T-labDevelopment/Voice_Memory/development/v2/README.md

# VoiceMemory v2 — 現行の製造承認版

**管理上の状態：製造承認済み（2026-11-11、ユーザー明示承認）**  
**製造基準：** `voicememory-2026-11-11_164201.zip`（2026-11-11 16:44 JST受領）

| 項目 | 内容 |
|---|---|
| 現行版 | **VoiceMemory v2** |
| 承認状態 | **製造承認済み（プロジェクト責任者による承認）** |
| 承認日 | 2026-11-11 |
| 承認対象 | [原本ZIP](../../hardware/source-archives/v2-baseline/voicememory-2026-11-11_164201.zip) |
| 原本SHA-256 | `a64d1d4d439a141a7048c7fe233227507cebeaa69209cd91ddddc90118438c7a` |
| 原本KiCad反映コミット | `e46e8d026885804b8783181245f9a54b088f07ca` |
| 承認記録 | [製造承認台帳](../../releases/v2-manufacturing-approved-2026-11-11/README.md) |
| 最新KiCad | [`hardware/kicad/voicememory/`](../../hardware/kicad/voicememory/) |
| 管理ブランチ | `develop/v2` |
| 旧v1 | [旧試作・製造検証資料](../../releases/v1-prototype/README.md)、費用計算不要 |

## 承認に関する証拠の区別

- **製造承認：あり。** プロジェクト責任者（ユーザー）が2026-11-11に上記v2 ZIPの製造承認を明示した。
- **ERC：実施済み（ユーザー申告）。DRC：実施済み（ユーザー申告）。**
- **KiCad CLIの独立再実行：なし。** ERC／DRCの正式レポートは原本ZIPに未収録。エラー／警告の個別件数は確認できておらず、**「ERC/DRCエラー0件・警告0件を検証済み」とは記さない**。
- 承認対象は上記固定ZIPと、その内容をGitHubに取り込んだKiCad一式。将来の変更、別ロットへの設計変更を包括承認するものではない。
- ファームウェアの完成・無線機との実機検証・量産品質保証の完了を意味しない。

## v2設計仕様（今回の製造基準）

- CH32V003F4P6、32Mbit SPI Flash（W25Q32RVCSJM）、NJM2732D、TLP592A(F)、AZ8462-3。
- 単3乾電池×3本、3.3V LDO。マイクと無線機の各RJ45 8P8C。
- M1～M4の4チャンネル録音・再生、ループ再生、マイクPTT優先と録音中の誤送信防止を目標仕様とする。ファームウェアの動作合格は別途管理。
- 最新の回路図・PCB・フットプリントは**11月11日ZIPの内容を優先**。
- 2026-11-10のコンデンサ干渉報告（C7/C10/C16/C19等）は、**旧PCBに対する履歴記録**。11月11日製造承認版の現存不良とはみなさない。

## 開発と調達

- [v2費用と必要仕様](DEVELOPMENT_AND_COST_SCOPE_JA.md)：費用はv2側で管理。調達額・組立費・開発工数は必要時に見積。
- [最新の受領・差分記録](../../hardware/reports/V2_BASELINE_RECEIPT_2026-11-11_JA.md)。
- 新しい修正を加える際には、この承認版を保持し、別コミット／ブランチで変更履歴と検証証拠を管理する。

**旧v1は独立した試作・製造検証用参照資料として保持し、v1の費用計算は行わない。**
