T-labDevelopment/Voice_Memory/releases/v1-prototype/README.md

# VoiceMemory v1 — 試作／製造検証用の基準資料

**位置付け：旧v1試作版（2026-10-30）。製造検証の比較・入力基準として保管し、現在の開発対象にはしない。費用計算は行わない。**

> **重要:** v1は製造検証のための参照元であり、「製造承認済み」「ERC/DRC済み」「動作保証済み」を意味しない。現在の設計を扱う場合は [v2開発版](../../development/v2/README.md) を参照する。

## 参照優先順位

1. **旧v1リリースZIP原本** `VoiceMemory_v1_ECO_2026-10-30_KiCad10(1).zip`（ユーザーが2026-11-11に提示）。
2. [同ZIPのファイル単位照合・SHA記録](../../hardware/reports/ECO_ZIP_RECEIPT_COMPARE_2026-11-11_JA.md)。
3. [2026-10-30 ECO変更記録](../../hardware/reports/ECO_2026-10-30_JA.md)。
4. [旧v1製造検証用チェックリスト](../../hardware/reports/ECO_RELEASE_CHECKLIST_2026-10-30_JA.md)。
5. [旧版ファームウェア仕様資料](../../docs/firmware-hardware/v1/README.md)（10月29日等の旧資料を含み、回路一致を要再照合）。

**原本ZIPは現在GitHubにバイナリとして登録できていない。** このフォルダは索引と同定情報を保存するもので、原本の完全な代替ではない。GitHubの `hardware/kicad/voicememory/` にあるSCH/PCBは**後続v2版**であり、旧v1原本と取り違えないこと。

## 原本識別情報

| 項目 | 内容 |
|---|---|
| 呼称 | VoiceMemory v1 試作／製造検証版 |
| 原本ファイル | `VoiceMemory_v1_ECO_2026-10-30_KiCad10(1).zip` |
| 作成基準日 | 2026-10-30 |
| 原本SHA-256 | `4701e9fb30755c0f9fe3589d3cfbdebf8b4f2a751e774f449c357264064692ce` |
| ZIP容量 | 134,456 byte |
| 収録 | 15ファイル（KiCad 10回路図・PCB・ライブラリ、ECO変更記録・監査資料） |
| 同一性確認 | 現行GitHubの15対応ファイル中13件は同一Git Blob SHA。差分2件は回路図とPCB |
| GitHubへ元ZIP格納 | **未完了** |
| v1の費用計算 | **不要／実施しない** |
| KiCad ERC / DRC | 未実施、エラー0件の検証は未達 |
| 製造承認 | **未承認** |

## v1試作の主要仕様

| 分野 | v1試作構成 |
|---|---|
| MCU | CH32V003F4P6 / 3.3V |
| SPI Flash | W25Q32RVCSJM / 32Mbit (4MiB)、208mil SOP-8 |
| 音声回路 | NJM2732Dデュアルアンプ、ADC録音／PWM再生 |
| 自動PTT | TLP592A(F) PhotoMOS |
| マイク音声・PTT切替 | AZ8462-3、3V DPDTリレー |
| 音声メモリ | M1～M4、4チャンネル |
| 想定PCM | 8kHz / 8bit / モノラル（FWで確定・検証が必要） |
| 録音上限 | 連続120秒で安全停止。120秒の保証ではない |
| 電源 | 単3×3本、3.3V LDO |
| 外部接続 | マイク側・無線機側RJ45 8P8C、WCH-Link |
| 操作 | REC＋M1～M4、2色状態LED |
| 主なコンデンサ | C11/C19は1µF・0603、0.1µF群は従来0805。後続v2の1206への置換前 |

ここに記載した機能・構成は当時の設計仕様およびECO資料に基づく。**実機で合格したことは示さない**。旧文書の端子表・部品表は古い回路世代を含むため、実装時はこのZIPの回路図／PCBを正とする。

## 製造検証で確認すること（試作評価）

- [ ] 原本ZIPのSHA-256が記録値と一致することを再照合する
- [ ] KiCad 10で原本プロジェクトを開き、ライブラリ解決・実部品実装位置を確認する
- [ ] 正式ERC：エラー0、警告0
- [ ] GNDゾーン再フィル、正式DRC：エラー0、警告0
- [ ] J1/J2 RJ45の実物端子方向・NPTH・ピン番号、各マイク信号の導通を確認する
- [ ] W25Q32RVのJEDEC ID／書込み／読出し／消去と電源断時の扱いを確認する
- [ ] TLP592A(F)のpin4/5/6、LED駆動、無線機PTT負荷定格を確認する
- [ ] リレーNCの通常パススルーと録音中の送信遮断、マイクPTT優先を実機確認する
- [ ] ADC録音／PWM再生／音量調整／連続録音／ループ間PTT解除を検証する
- [ ] 検証結果を日付・基板個体・ファームウェアcommit・計測値とともに記録する

当時の正式チェックリストは [こちら](../../hardware/reports/ECO_RELEASE_CHECKLIST_2026-10-30_JA.md)。この再整理で未実施項目を完了扱いに変更しない。

## 版の取り扱い

v1試作の原本は不変として扱う。**v1について部品原価、開発費、調達費の試算は作成しない**。今後の設計変更・仕様追加・費用管理は [v2開発版](../../development/v2/README.md) に集約し、原本を上書きしない。
