T-labDevelopment/Voice_Memory/hardware/kicad/voicememory/README_JA.md

> **2026-11-11 製造承認更新（現行v2）：** このディレクトリの現行KiCad設計は `voicememory-2026-11-11_164201.zip` に基づく**v2製造承認済み版**です。承認はユーザー明示判断に基づきます。詳細は [製造承認記録](../../../releases/v2-manufacturing-approved-2026-11-11/README.md)。下記の2026-10-29～11-10までの「v1」「未承認」等は**旧版・当時の履歴**として保存しており、現行の承認状態を表しません。正式ERC/DRCレポートは未収録、エラー／警告件数は独立未検証です。

> **現在の版の注意（2026-11-11）:** このディレクトリにあるKiCad回路図・PCBは、2026-11-10コンデンサ変更を含む**v2開発・レビュー用データ**です。以下の旧README本文は2026-10-29受領当時の履歴説明であり、最新現況ではありません。v1試作版は[別枠の参照索引](../../../releases/v1-prototype/README.md)、現在のv2仕様は[v2開発資料](../../../development/v2/README.md)を使用してください。**製造用承認は未取得。**

> **更新（2026-10-30）**：本READMEは受領原本の説明です。修正済みECO版を使用する際は `README_ECO_2026-10-30.md` と `../../reports/ECO_2026-10-30_JA.md` を優先してください。

# VoiceMemory v1 – 最新受領KiCadデータ

- 受領日: 2026-10-29 (JST)
- 入力ファイル: `voicememory-2026-10-05_162836(2).zip`
- 入力ZIPのSHA-256: `b34d0f4ad92e3c439bdc9cf07ba6ea58b797cbf73fb96d74d4353c6b7bf29787`
- 回路図とPCBの保存バージョン: KiCad 10.0
- 本ディレクトリは、ユーザー提供ZIPから変更せず抽出した設計データである（`.kicad_prl` のみ端末依存ファイルとして除外）。元のZIP全体は `hardware/source-archives/` に保全する。
- 以前からあったリポジトリ直下の `Voice_Memory.pretty/` は参考として残している。**本受領版を開くときは必ずこのディレクトリ内のKiCadプロジェクト、sym-lib-table、fp-lib-table、Voice_Memory.prettyを使用すること。**
- Git タグ `v1` は初回の参照仕様記録（不完全な設計データ）を指す。今回はそれを改変せず、別タグ `v1-data-2026-10-29` に実データのスナップショットを保存する。

## 読込み状態と未反映の変更指示

アップロードZIPは現在の**最新受領実ファイル**である。一方で、過去のチャットで採用決定したが実ファイルに反映されていない変更内容が存在する。勝手に置換せず記録する。

| 項目 | 本ZIP内の実データ | 従来の採用・検討内容との関係 |
|---|---|---|
| U1 | CH32V003F4P6 | 維持 |
| U2 | AT25SF321B-SSHB / SOIC-8 150mil | 別途指定のW25Q32RVCSJM（208mil幅）には未置換 |
| U3 | AQV212 / DIP-6 | 後続のTLP592A(F)採用指示は未反映 |
| U4 | NJM2732D / DIP-8 | キャッシュ・シンボルがMCP6002-xP由来である点に注意。実部品のピン互換・動作は実機未検証 |
| C11・C19 | 1µF/25V / 2012(0805) | 後続の1608(0603)案は未反映 |
| C1 | 10µF/35V / 3216(1206) | 維持 |
| R1～R20 | 全品2012(0805)、R20=270Ω | 全面THT化案は撤回済み（本データはSMDのまま） |
| C3・C6・C9・C13 | 100µF/16V THT φ5/P2.0 | 維持 |
| J1/J2 | RJ45 8P8C。2×φ3.20mm、12.70mm間隔のNPTHを含む | 過去に別途作成した固定穴修正版とピン1基準で穴位置Yが逆。現物との照合は未確定 |

### RJ45固定穴の相違について

本ZIPのJ1/J2部品フットプリントには、信号1番パッド（-3.57,0）に対して左固定穴が(-6.35,-4.32)にあり、相対位置は **(-2.78, -4.32)mm** となる。
前回作成した修正用フットプリントでは1番パッド(0,0)に対して **(-2.78,+4.32)mm** である。
左右の穴中心間12.70mmと穴径φ3.20mmは一致するが、**端子列に対する穴の上下方向が異なる**ため、図面・部品・PCBを再照合するまで一致確認済みと扱わない。本ZIPは原本保存のため無変更とした。

## 検証範囲

- ファイルの読取りとKiCad構文の機械的解析を実施。回路図の実部品61件はPCB上にも参照番号が存在する。
- PCB内の部品65個は「部品61件＋取り付け穴4件」であり、取り付け穴はRef=`REF**`のまま（リファレンスの正式割当ではない）。
- **KiCad 10 CLIによるERC・DRC、およびシンボル電気属性、全ネットの配線導通、物理寸法、部品実装は未検証。製造可能と断定しない。**
- 以前作成したファームウェア開発者向け文書は本受領版に合わせて再監査する必要がある。特にFlash、PhotoMOS、アンプ型番は確認対象。
