T-labDevelopment/Voice_Memory/hardware/reports/CAP_MIN_0805_2026-11-10_JA.md

> **バージョン区分（2026-11-11確定）：** 本書が扱う2026-11-10のコンデンサ変更およびKiCadプロジェクトは、現在**v2開発・レビュー版**として管理します。本文に残る `v1` は当時の作業呼称を示す履歴です。[v2開発資料](../../development/v2/README.md)を参照。製造承認状態は変更していません。

# VoiceMemory v1 — 最小0805・部品調達見直し（2026-11-10）

## 位置付け

直前の `v1-cap-sourcing-2026-11-10` による **0603（1608）への小型化を撤回**。最小SMDサイズを **0805（2012 Metric）** とし、店頭・通販調達性から **1206（3216 Metric）** に大型化する。`0803` は過去会話と部品表から `0805` の誤記として扱う。電解コンデンサ、抵抗、リレー、MCU、音声回路、RJ45修正は現状維持。

**このZIPのPCBは拡大フットプリントを仮配置した「レビュー用候補」であり、製造データではない。** 1206への変更でPCBの近傍銅配線が衝突するため、正規DRCと実配線改修が必要。

## 部品選定（1台当たり）

| Ref | 個数 | 電気的仕様と型番 | 仕入先・コード | サイズ | 10台分購入目安 | 判定 |
|---|---:|---|---|---|---:|---|
| C7,C8,C10,C14,C15,C16,C17 | 7 | Murata **GRM31C2C2A104JA01L**、**0.1µF / 100V / CH（JIS）±5%**。元の0.1µF/100V/X7R（直前採用）から誘電体特性が変わる | 千石電商・型番検索 | **1206** | 50個1組1200円 + 10個2組600円 = **1800円／70個** | 店舗掲載確認・実在庫要発注時確認 |
| C2,C4,C11,C19 | 4 | Rubycon **25MU105MA23216**、**1µF / 25V / PMLCAP**（SMD薄膜高分子積層フィルム） | 秋月 **107397** | **1206** | 40個 × 70円 = **2800円／40個** | 通販在庫あり |
| C1 | 1 | **GMK316AB7106KL-TR**、10µF / 35V / X7R | 秋月 **130977** | **1206** | 既存調達維持 | 変更なし |
| C5,C12 | 2 | **GRM2165C2A102JA01D**、1nF / 100V / C0G | 千石・型番検索 | **0805** | 既存調達維持 | 変更なし |
| C18 | 1 | **GRM21BR61A106KE19**、10µF / 10V / X5R | 秋月 **117592** | **0805** | 既存調達維持 | 変更なし |
| C3,C6,C9,C13 | 4 | 電解 100µF / 16V | 調達済みTHT品 | **THT φ5、P2** | 調達済み部品を維持 | 変更なし |

**今回変更する11個／台の購入目安：10セット分で合計4600円（1セット当たり460円）。** 送料を除き、最新の税込掲載価格で購入ロットを計算したもの。PMLCAP 1µF 40個の価格と、千石50個+10個+10個の価格は購入画面で要最終確認。

### 元仕様との電気的相違

- **C7～C17の該当7箇所**：0.1µFを維持、前回の100Vを維持。前回のX7R MLCCから **CH（JIS）MLCC** に変更（**C0Gとは記載しない**）。CHは温度係数が小さいクラス1系だが、デカップリングとしての高周波インピーダンス・自己共振・配置は試作確認が必要。
- **C2/C4/C11/C19**：1µF / 25Vを維持。MLCCからSMDフィルム（PMLCAP）へ変更するので **材料特性・ESR/ESL・直流バイアス依存が同一ではない**。特にC2/C4は電源の高周波デカップリング、C11/C19は信号AC結合で、用途別に動作検証する。
- **C5/C12**：1nFのC0G回路なのでそのまま維持する。0.1µFへの混同は禁止。
- 0.1µFの秋月旧品 117576（0805 X7R 50V）と1µF旧品115331（0805 X7R 50V）は販売終了。条件に合わない安価な0603品を使わない。

## KiCad反映の現状

- `hardware/kicad/voicememory/voicememory.kicad_sch`：11個のValueとFootprintを変更。
- `hardware/kicad/voicememory/voicememory.kicad_pcb`：同じ11個に、既存のKiCad10標準1206フットプリント（基板内C1由来）の**標準形状を丸ごと使用**して置き換え。配線接続番号・ネット名・パッドUUID・配置中心を維持。標準シンボルを再生成・独自省略しない。
- それ以外のパーツと配線・ビアについては意図的な変更をしていない。
- **PCBは再配置／再配線が必要な候補データ**。自動的に製造可能な基板に変わったわけではない。

## 静的スクリーニングで新たに検出された接近／干渉

`hardware/reports/CAP_MIN_0805_STATIC_GEOM_2026-11-10.json` を参照。パッドとF.Cu配線・ビアを2D形状で近接判定（閾値0.25mm）した結果、以前の状態から**9件**の追加フラグが出た。複数フラグは同じ根本的干渉に関わる。

- **C7**：U1 pin10 `LED_R` および `LED_R` 配線と近接・重なり（`C7-1 +3V3`、`C7-2 GND_AUD`）。最優先でC7の位置とLED_R配線を再配置。
- **C10**：`C10-2 GND_AUD` パッドと `RELAY_COIL_LOW` 配線が重なる。
- **C16**：`C16-1 PWM_F2` パッドと `MIC_AUDIO` 配線・GNDビアが接近または重なる。
- **C19**：`C19-1 PLAY_BIASED` パッドとGNDビアが重なる。

上記の一部は距離0mmであり、**現時点でショートの可能性が高い**。元から存在する問題と区別して差分記録した。**未修正のままGerber出力・基板発注は禁止。**

## 正式検証・残作業

1. KiCad 10で対象11部品を場所に余裕があるエリアへ再配置し、必要なネットを再配線。特にC2/C4/C7/C8/C10/C14~C17はデカップリングの接続距離を短く保つ。
2. ZoneのGND再フィル（PCB `B` キー）。銅箔近接、異ネット短絡、アンテナ/コネクタ等の他の条件も確認。
3. **KiCad 10正式ERC0エラー・0警告とDRC0エラー・0警告**を目標に実行し結果を保存。
4. C1,C2,C4,C11,C19の部品ごとに端面電極とフットプリント寸法を実部品仕様で照合。
5. 0.1µFのCH品・PMLCAPの置換によるノイズ、ADC/SPI/音声動作を実機で確認。

**正式ERC・DRC、ゾーン再フィル、実装・実機評価は未実施。**

## 出典と確認情報

- [千石：GRM31C2C2A104JA01L / 1206 0.1µF 100V, 10個300円・50個1200円](https://www.sengoku.co.jp/mod/sgk_cart/search.php?cid=4440)（掲載、実在庫数は不明）
- [Murata公表部品リスト：GRM31C2C2A104 / 0.1µF、100V、温度特性CH（JIS）](https://www.murata.com/-/media/webrenewal/tool/library/common-pdf/static-model/component-list-s-mlcc-2506.ashx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)
- [秋月 107397：25MU105MA23216 / PMLCAP 1µF25V3216、70円](https://akizukidenshi.com/catalog/g/g107397/)
- [秋月 130977：10µF35V X7R 3216](https://akizukidenshi.com/catalog/g/g130977/)
- [秋月 117592：10µF10V X5R 2012](https://akizukidenshi.com/catalog/g/g117592/)
- [秋月 117576：0.1µF50V X7R 2012（販売終了）](https://akizukidenshi.com/catalog/g/g117576/)
- [秋月 115331：1µF50V X7R 2012（販売終了）](https://akizukidenshi.com/catalog/g/g115331/)
