T-labDevelopment/Voice_Memory/hardware/reports/ECO_2026-10-30_JA.md

# VoiceMemory v1 — 受領旧データへの変更反映（2026-10-30）

## 元ファイル／保存方針

- 入力：`voicememory-2026-10-05_162836(2).zip`（2026-10-29受領）。
- 無変更の原本は `hardware/source-archives/` に保存している。
- このECOは、原本と別のGitブランチ `fix/v1-eco-2026-10-30` で実施した。
- 既存の `v1` および `v1-data-2026-10-29` タグは動かさない。
- KiCadは受領データの **10.0** フォーマットを維持。抵抗・コンデンサの全面THT化は撤回済み。

## 回路図・PCB・ライブラリに実施した変更

| Ref | 変更内容 | ファイル状況 |
|---|---|---|
| J1/J2 | ユーザー図面に従い、固定用NPTH φ3.20 ×2の中心をパッド1基準で (-2.78,+4.32) / (+9.92,+4.32) に補正。元FPの原点では穴Y=-4.32→+4.32、X=±6.35 | ローカル `.pretty` とPCB両方変更。パッド1～8の番号・座標・ネット・UUIDは維持 |
| C11/C19 | 1µF /25Vを2012(0805)から1608(0603)のKiCad標準 `Capacitor_SMD:C_0603_1608Metric` に変更 | 回路図のFootprint、PCB上の部品形状・パッド変更。ネット・極性なしは維持 |
| U2 | `AT25SF321B-SSHB`→`W25Q32RVCSJM`。208mil SOP-8用 `Package_SO:SOP-8_5.28x5.23mm_P1.27mm` を適用 | 回路図キャッシュ・実ライブラリ・PCBの名称、実PCBパッド形状を変更。8本の同一番号の接続を維持。パッドへの補修配線を追加 |
| U3 | `AQV212`→`TLP592A(F)`（DIP6） | 回路図・実ライブラリ・PCBのValueを変更。ピン1=A,2=K,3=NC,4=DRAIN_D1,5=SOURCE,6=DRAIN_D2に更新。出力は4/6、5は外部未結線 |
| R2/R3 | U2の208mil用ランドと既存抵抗との物理干渉を避けるため0.75mmだけ外側に移動 | PCB配置と既存パッドに接続する短い補修配線を変更。抵抗値は無変更 |
| RJ45周辺配線 | PTT_GND、MIC_DOWN、MIC_DC_PASSの旧固定穴位置を横断していた銅配線を迂回 | PCB配線とMIC_DC_PASS用ビア1個を変更。各ネット名維持 |
| GND銅ベタ | 古い穴位置に基づいた**キャッシュ済みの塗りつぶし**23要素を除去 | Zone定義そのものは維持。**必ずKiCad上で「B」を押してゾーン再フィルして保存** |

## 無変更部品・撤回方針

- R1～R20は全てSMD 2012 (0805)、1/8W・±5%を基準とし、R20=270Ωを維持。
- C1は10µF/35V、SMD 3216 (1206)のまま。
- C3、C6、C9、C13は100µF/16V THT電解、既存調達品を維持。
- C2、C4などその他の実装コンデンサは変えない。
- U4(NJM2732D)やその他の部品・基板外形、操作・録音仕様は変更しない。

## メーカー・標準データ

- RJ45：ユーザー提示の実ジャック裏面写真とPCB LAYOUT寸法図（固定穴φ3.20mm、ピッチ12.70mm、千鳥配列1.02/1.78mm）。**実ジャックの端子番号と基板の端子番号の完全一致は要実測。**
- C11/C19：KiCad公式 `Capacitor_SMD:C_0603_1608Metric` の公称形状・端子寸法に準拠。調達候補村田 `GRM188B31E105KA75`、1µF/25V、1608。
- U2：Winbond W25Q32RVCSJM、3.3V、32Mbit、208mil SOP-8。PCBの新フットプリントはKiCad公式 `Package_SO:SOP-8_5.28x5.23mm_P1.27mm`。**実ICのリード外形・はんだランド許容差を最終チェックすること。**
- U3：東芝TLP592A公式データシート、DIP6 1/2 LED、4/5/6 出力（外部出力を4/6で使用し5は未接続）。

## 検証状態と製造保留

- **実行済み**：KiCadファイル構造とRef／パッド番号・ネット名の静的解析、RJ45固定穴と既存銅配線・ビアの概略間隔確認、新配線との接触スキャン、更新対象部品の座標検証。
- **未実施**：実際のKiCad 10アプリ／`kicad-cli`によるERC／DRC、PCBゾーン再フィル、製造Gerber出力、実機の端子番号測定、Flash読み書きテスト。
- **残るリスク**：RJ45固定穴付近のGNDベタは再フィル未実施。新固定穴周辺の銅配線／ビアの余裕は箇所により0.33～0.35mm程度と小さいため、製造ルールに従いDRCで要確認。U2のIC外形とランドおよび周辺R2/R3の間隔、C11/C19の新ランドからの旧トレース接続も必ず確認。
- **ファームウェア注意**：SPI FlashがRenesas/Adesto AT25SF321BからWinbond W25Q32RVへ切り替わったため、JEDEC ID、Status/Erase/Program命令とタイミング、保護ビット挙動はW25Q32RV用に再確認すること。PhotoMOSは制御論理を維持するが、LED電流・PTT定格は実機確認すること。
- **判定**：**製造可ではない**。ERC 0、DRC 0、再フィル・パッド番号照合が終了するまで評価版。

参照データ（機械処理結果）： `ECO_2026-10-30.json`、`ECO_STATIC_CHECK_2026-10-30.json`、`ECO_PROXIMITY_2026-10-30.json`、`ECO_NEW_TRACK_CLEARANCE_2026-10-30.json`。
