T-labDevelopment/Voice_Memory/hardware/reports/ECO_RELEASE_CHECKLIST_2026-10-30_JA.md

# VoiceMemory v1 ECO リリース前チェックリスト

- [x] 原本ZIPを無変更でGit保管
- [x] J1/J2ライブラリと実PCBの固定穴を変更
- [x] C11/C19を標準1608へ変更（回路図／PCB）
- [x] U2をWinbond W25Q32RVCSJM、SOP-8 208milに変更（回路図／PCB）
- [x] U3を東芝TLP592A(F)に変更（回路図／PCB）
- [x] U2拡張によるR2/R3干渉を避ける配置変更と接続補修
- [x] RJ45固定穴干渉配線の迂回・新ビア挿入
- [x] 旧GNDゾーン塗りつぶしデータを削除して再計算要求
- [x] 回路図・基板ファイルの括弧・文字列の静的構文チェック
- [x] 回路図側U2/U3とPCB側Value／footprintの確認
- [x] 各Refのパッド番号と電気ネットの概略照合
- [ ] **KiCad 10でGNDゾーン再フィル（Bキー）して保存**
- [ ] **KiCad 10正式ERCを実行しエラー0・警告0を確認**
- [ ] **KiCad 10正式DRCを実行しエラー0・警告0を確認**
- [ ] **RJ45実ジャックの端子1・向き・固定突起が一致するか確認**
- [ ] **Winbondパッケージ実寸・周辺銅クリアランス・実装方向の確認**
- [ ] **U3 4/5/6番の基板接続と使用端子・部品定格を実機確認**
- [ ] **U2のJEDEC ID／書込み／消去／電源断時の実機確認**

判定：**評価版（製造データとして未承認）**。KiCad CLIがこの実行環境に無いためERC/DRCは一切実行していない。
