T-labDevelopment/Voice_Memory/hardware/kicad/voicememory/README_CAP_MIN_0805_2026-11-10.md

> **現行v2の製造承認に関する注記：** 本書は2026-11-10段階の**旧PCB**に対する作業報告です。2026-11-11のv2基準ZIPではPCBが更新され、ユーザー承認により**製造承認済み**となっています。本書の「製造禁止」「DRC未実施」は旧PCB評価時点の記録であり、現行承認版を指しません。[承認版の記録](../../../releases/v2-manufacturing-approved-2026-11-11/README.md)。

> **対象版：v2開発・レビュー版。** このコンデンサ変更を含むファイルが現在の管理対象です。旧v1の試作・製造検証用資料は[こちら](../../../releases/v1-prototype/README.md)。

# コンデンサ最小サイズ：0805（2012）

- 前の0603化11個を1206（3216）へ変更した「**PCB修正途上のレビュー版**」。
- KiCad標準のC_1206_3216Metricを使用し、既存ネットとパッドUUIDを維持。
- 新規のパッド／銅配線干渉を複数検出。**製造用には使用禁止**。
- 詳細：`../../reports/CAP_MIN_0805_2026-11-10_JA.md`。
- PCBの修正配線、KiCad正式ERC/DRCおよびGNDゾーン再フィルが必要。
