T-labDevelopment/Voice_Memory/docs/firmware-hardware/v1/ECO_2026-10-30_注意.md

# ファームウェア開発者向け追補（2026-10-30）

ファームウェア仕様書の初版PDF/DOCXに記載されたU2/U3の型番は、2026-10-30 ECO以前のものです。現在のKiCad設計ではU2=`W25Q32RVCSJM` (32Mbit)、U3=`TLP592A(F)`です。ADC/PWM、SW、I/OとPTT/リレー制御のネット接続は変えていません。

更新資料の優先順位：`hardware/kicad/voicememory/voicememory.kicad_sch` と `.kicad_pcb` → `hardware/reports/ECO_2026-10-30_JA.md` → 旧ファームウェア仕様書。新しいU2用のJEDEC IDとSPI操作は実機で検証すること。

**製造可能な検証済み基板を意味するものではありません。**
