T-labDevelopment/Voice_Memory/hardware/kicad/voicememory/README_ECO_2026-10-30.md

# KiCad 10 最新改版について

原本（2026-10-29受領）に対して、2026-10-30のECOを適用済みです。

- 更新したデータ：`voicememory.kicad_sch`、`voicememory.kicad_pcb`、`Voice_Memory.kicad_sym`、`Voice_Memory.pretty/RJ45_8P8C_THT_15.91x15.10.kicad_mod`
- 作業基準は原本からのGit差分。詳細は `../../reports/ECO_2026-10-30_JA.md`。
- 本プロジェクトは**設計更新済み／KiCad ERC・DRC未実施／製造未承認**です。
- 最初にKiCad 10で開き、`B`キーでGNDゾーンを再フィルして保存し、ERC/DRCを実行してください。必要に応じてRJ45とWinbond U2のクリアランス／配線を修正してください。
- スクリーンショット用や説明用の図面より、同梱の `.kicad_sch` と `.kicad_pcb` が優先です。
