T-labDevelopment/Voice_Memory/docs/firmware-hardware/v1/sources/README_ORIGINAL_REFERENCE_IMAGES.md

# RJ45 original reference images — missing source status (2026-11-11)

Original user-supplied reference images were named `RJ45_PCB_LAYOUT_寸法図.png` and `RJ45_部品裏面参考写真.jpeg`. Neither file was found as an individual uploaded item or within the current GitHub tree. Do not substitute fabricated photos or pretend that reconstructed drawings are original evidence.

The actual KiCad 10 footprint currently used by this project is at `../../../../hardware/kicad/voicememory/Voice_Memory.pretty/RJ45_8P8C_THT_15.91x15.10.kicad_mod`.
The new technical illustration `../figures/rj45_footprint_layout.svg` displays the current footprint coordinates, **not** the original user-supplied drawing.

The real jack's signal pad numbering and mechanical pin-1 orientation must be checked on hardware. Original visual references are still missing.
