T-labDevelopment/Voice_Memory/docs/firmware-hardware/v1/sources/KICAD_APPLICATION_STATUS_JA.md

# KiCad v1データへの適用状況

| 対象 | v1指定 | ファイル状況 | KiCad/PCBへの適用 |
|---|---|---|---|
| J1/J2 RJ45修正フットプリント | 採用 | `.kicad_mod`収録 | 既存PCB未反映 |
| R1～R20 SMD 2012 | 維持 | 既存ZIP名のみ把握 | 原本未取得・未照合 |
| C1 10µF 3216 | 維持 | 既存ZIP名のみ把握 | 原本未取得・未照合 |
| C11/C19 1µF 1608 | 方針維持 | 原本未取得 | 現PCB未反映 |
| C3/C6/C9/C13 電解 | 無変更 | 原本未取得 | 既存設計を維持 |
| ほかの回路 | 無変更 | 原本未取得 | 既存設計を維持 |

この作業環境では元KiCadプロジェクト `.kicad_pro`、`.kicad_sch`、`.kicad_pcb`及び全ライブラリを取得できないため、完全なv1プロジェクトとして扱わない。受領時には設計データをこの版の仕様に照合し、原本差分確認後に追加・検証する。PCB更新時、旧配線位置・端子番号・穴クリアランスを必ず確認する。

RJ45修正図面で確認した寸法：固定穴径φ3.20 mm×2、中心間12.70 mm、信号ピン穴φ0.90 mm×8、ピッチ1.02 mm / 列間1.78 mm、固定穴上段信号ピンからのオフセット4.32 mm。写真と寸法図の端子1番方向は未確定。
