T-labDevelopment/Voice_Memory/docs/firmware-hardware/v1/sources/V1_BASELINE_JA.md

# HK829代替ボイスメモリー — v1基準仕様（2026-10-28）

## バージョン指定
- 設計呼称：**VoiceMemory v1**
- Git上の版名：`v1`（この参照用リポジトリのローカルタグ）
- KiCad上の版名：`v1`（既存プロジェクトの次回受領時に適用するバージョン指定）
- 版の基準：2026-10-28直前のSMD主体構成。抵抗・コンデンサ全面THT化検討は白紙撤回。

## 含める設計判断
- R1～R20：SMD 2012 (0805)、1/8 W、±5%を原則とし、採用済みの抵抗値を維持。
- コンデンサ：SMD主体。既存のTHT電解 C3/C6/C9/C13 (100 µF/16 V)は維持。
- C1：10 µF、SMD 3216 (1206) を基準。
- C11/C19：1 µF、調達改善案のSMD 1608 (0603) を採用方針とする。ただし実PCBへの反映は未確認。
- C18：10 µF、SMD 2012 (0805) の現行調達仕様を維持。
- J1/J2：RJ45固定穴位置をユーザー提示の寸法図に合わせる修正フットプリントを採用。実PCBへの反映は未確認。
- 録音、再生、SPI Flash、PTT等の既存の機能・配線は変更しない。
- 電解コンデンサ及びその他の調達済み部材を、THT全面変更のために置換しない。

## 参照元
- チャット上の基準KiCad ZIP名：`voicememory-2026-10-05_162836.zip`（このリポジトリには未収録）。
- 2026-10-19版の調達BOMと、その後の1 µF調達改善決定。
- 2026-10-25ユーザー提供のRJ45部品裏面写真及びPCB LAYOUT寸法図。
- `Voice_Memory.pretty/RJ45_8P8C_THT_15.91x15.10.kicad_mod`（このリポジトリに収録）。

## 除外した案
- R1～R20すべてをTHT 1/8 Wへ変更する案。
- 未調達コンデンサを一律THT化する案。
- C1/C18を電解コンデンサに置き換える案。

## 適合性・検証状態
- **KiCad回路図・PCB全体のv1反映は未実施**。
- KiCad 10 ERC/DRC：未実施。機械実装：未検証。
- 変更予定・調達候補と、KiCad原本へ反映された値は区別する。
- `v1` は仕様上の版名として確定したが、完全な製造可能データの存在を意味しない。
