T-labDevelopment/Voice_Memory/README_CAP_MIN_0805.md

# VoiceMemory v1 最小0805・調達性再検討（レビュー版）

本フォルダは v1 `v1-cap-sourcing-2026-11-10` からの作業変更であり、**製造可能なKiCad基板を意味しない**。

最新部品採用・要再配線箇所：`hardware/reports/CAP_MIN_0805_2026-11-10_JA.md`

変更差分自動適用：`scripts/apply_cap_min0805_20261110.py` （元ブランチから実行すること）

追加干渉の静的検査：`scripts/audit_cap_min0805_20261110.py`

DRC/ゾーン再フィルは未実行。旧v1タグ、旧文書と過去回路は維持。
