T-labDevelopment/Voice_Memory/releases/legacy-v1-2026-10-30/README.md

# 旧v1リリース版 — 保存基準（2026-10-30）

## リリース版の確定

2026-11-11、ユーザーからの明示により、`VoiceMemory_v1_ECO_2026-10-30_KiCad10(1).zip` は**旧v1のリリース版**として確定した。単なる試作中間ECOではない。

- 元ファイル名: `VoiceMemory_v1_ECO_2026-10-30_KiCad10(1).zip`
- SHA-256: `4701e9fb30755c0f9fe3589d3cfbdebf8b4f2a751e774f449c357264064692ce`
- ZIPサイズ: 134456 byte
- 内容: KiCad 10回路図・PCB・シンボル・フットプリント、変更記録、静的監査、リリース前チェックリスト等の15ファイル
- ZIP内容のCRC検査: 合格
- 同一性の照合: 現行11月10日版GitHubと13/15ファイルが同じGit Blob SHA。不一致は回路図とPCBの2ファイルのみ。
- 完全な元ZIPのGitHubバイナリ登録: **未実施**（現在のGitHub作業ブランチには本ZIPそのものは存在しない）。
- 元ZIPの実バイト列はこのチャットにアップロードされた添付として確認済みである。元ファイルを編集・再圧縮しない。

## 世代区分

| 区分 | 版 | 状態 |
|---|---|---|
| 旧リリース基準 | 2026-10-30 `VoiceMemory_v1_ECO_2026-10-30_KiCad10(1).zip` | **旧v1リリース版として保存**。後続の開発変更で上書きしない |
| 後続の現行設計 | 2026-11-10 `v1-cap-min0805-review` | コンデンサ再選定を伴う開発・レビュー用の現行ブランチ |
| `main` | リポジトリ初期状態 | 旧v1のリリース内容とも後続開発版とも同一とは断定しない |

「旧v1のリリース版」という版の区分はユーザー指定であり、KiCad ERC/DRC・製造認定を行ったという意味ではない。ZIP中の `RELEASE_CHECKLIST_JA.md` の最終判定は**「評価版（製造データとして未承認）」**である。この記述は改変せずそのまま尊重する。

## 管理上の取り扱い

1. 元ZIPのハッシュを不変の同定子として記録する。
2. 旧v1を修正したい場合は、旧リリース版を変更するのではなく、別の作業ブランチ・後続版として差分を作成する。
3. ユーザーの明示的な指示なしにGitHubの既存タグ `v1` を別コミットへ付け替えたり、`main` へ統合したりしない。
4. 現行11月10日版の回路図・PCBには、旧リリース版で上書きしない。
5. 元ZIP自体をGitHubにバイナリ登録していない現状を、**「完全アーカイブ登録済み」とは表現しない**。

詳細ハッシュ・ファイルごとの比較は [ECO_ZIP_RECEIPT_COMPARE_2026-11-11_JA.md](../../hardware/reports/ECO_ZIP_RECEIPT_COMPARE_2026-11-11_JA.md) に記録。

## 追加の未完了

- 同一ZIPのバイナリをGitHubリポジトリの独立保管領域へ登録
- 元ローカルGit履歴のネイティブGitHub履歴への完全移植（別作業）
- KiCad正式ERC/DRC、ゾーン再フィル・実機検証（旧v1リリースの製造承認とは切り分ける）

## 2026-11-11 管理区分の更新

**本データはv1試作・製造検証用の旧版基準**です。v1についての開発費、部品費、調達費の計算は行いません。現在の開発対象は**v2**へ移行しました。参照入口は [v1試作専用の索引](../v1-prototype/README.md)、現在の設計は [v2開発資料](../../development/v2/README.md) を使用します。原本ZIPは未アップロードであること、ERC/DRC未実施であることに変更はありません。
