T-labDevelopment/Voice_Memory/development/v2/DEVELOPMENT_AND_COST_SCOPE_JA.md

# VoiceMemory v2 — 開発・試作費および必要仕様の管理範囲

**対象はv2のみ。v1は試作の歴史的基準資料であり、費用計算を行わない。**

> **2026-11-11 製造承認更新：** v2基準KiCadはユーザー判断により製造承認済み。設計修正を前提とした旧版の記述は履歴扱いで、現行承認データに追加修正が必要と断定しません。[承認記録](../../releases/v2-manufacturing-approved-2026-11-11/README.md)

## 費用の分類

| 区分 | 内容 | 現状 |
|---|---|---|
| 電子部品材料費 | MCU、SPI Flash、PhotoMOS、リレー、アンプ、抵抗／コンデンサ等 | 調達候補あり。v2 BOMの全項目再照合が必要 |
| 基板製造費 | PCB枚数、板厚、層数、送料、予備基板 | 見積未確定 |
| 外付け部品費 | 電池ケース、電源スイッチ、RJ45、配線、JST接続、筐体 | 必要仕様を整理。調達・在庫条件で変動 |
| 組立・検査費 | SMD/THT実装、接点導通、電源・音声・送信試験 | 工数・単価未確定 |
| ファームウェア開発費 | CH32V003上の録音、SPI Flash、4ch/ループ、PTT、異常停止 | 工数・単価未確定 |
| 設計修正・再試作費 | 承認版以降に改版が必要になった場合の費用 | 現行v2は製造承認済み。改版費は未算出 |
| 治具・工具・機材費 | WCH-Link、電源、オシロ／テスタ等（既存資産含む） | 新規支出と既存資産を分ける |

**現段階でv2の総開発費や製品単価を確定額として提示しない。** 過去BOMは版・調達条件が異なるため、そのままv2の原価には使用できない。

## v2に関する参考購入額と扱い

- 2026-11-10に行った**v2コンデンサ見直し**では、対象11個/台（0.1µF×7、1µF×4）の**10台分参考購入額4,600円**（0.1µF群1,800円、1µF群2,800円）が記録されている。これは当該部品のロット購入参考額であり、v2の基板1台あたりの総部品費ではない。
- 他の部品費・基板製造・組立・開発工数・RJ45・ケース・送料を加味した**v2総開発費は未算出**。
- 過去の部品BOMは現在の部品構成・在庫・購入先と相違があるため、**旧版の費用をv1に配賦したり、そのままv2の確定額に転用したりしない**。v1についての費用計算は行わない。
- 2026-11-10価格は現在価格を保証しない。v2購入確定時には最新のBOM、実在庫、送料、発注単位を確認する。

## v2試作用費用見積に必要な前提

- 製造数量（1台／5台／10台等）、予備基板・予備部品の有無
- 既存在庫と新規購入品の区別、調達先・ロット価格・送料
- v2の最新PCBから生成したBOM（Ref、Value、Footprint、メーカー型番、調達コード）
- U2、U3、リレー、RJ45などの実装・寸法の承認状況
- ファームウェア工数（実装・単体／結合試験・実機デバッグ）と工数単価
- PCB作成、検査治具、筐体・ケーブル・電源部の範囲

必要条件が揃うまで **未見積／概算** と明記し、未確定部品を0円扱いしない。

## v2の必要仕様と検証ゲート

### ハードウェア必須項目

- KiCad 10.xを用い、回路図・PCB・フットプリント・ネット・端子番号を一致させる。
- 50mil接続グリッド、電源供給属性、PWR_FLAG、グローバルラベルの方向・位置を確認する。
- 0.1µFと1µFの変更対象、定格電圧・誘電体・外形寸法・入手性を照合する。
- MCU、Flash、PhotoMOS、リレー・オペアンプの電源定格と実装ピンを確認する。
- ERC／DRCでエラー0・警告0を達成し、検証ログをGit管理する。

### ファームウェア必須項目

- CH32V003のピン割当、SPI FlashのJEDEC ID照合、電源投入時の安全初期化。
- 4メモリの録音・再生、マイクPTT優先、録音中の送信遮断。
- ループ再生時の自動PTT解除間隔、最大連続録音120秒の安全停止。
- 記録中の電源断、無効データ、Flash故障、PTT異常時の安全処理。

**検証未実施を完了扱いにせず、v2の仕様・費用は本フォルダで更新していく。**

## 出典

- [現行v2コンデンサECO](../../hardware/reports/CAP_MIN_0805_2026-11-10_JA.md)（2026-11-10）
- [現行KiCad](../../hardware/kicad/voicememory/)
- 旧参考資料：ユーザーが保存した `HK829_VoiceMemory_10set_BOM_Procurement_2026-10-19.xlsx`（現在リポジトリには同名XLSX未収録）。v2で引用する場合は版差を必ず確認する。
