T-labDevelopment/Voice_Memory/hardware/reports/CAP_SOURCING_2026-11-10_JA.md

# VoiceMemory v1 — チップコンデンサ調達性改善 ECO（2026-11-10）

## 目的・前提

前工程 `v1-eco-2026-10-30` を正本として、秋月電子・千石電商で調達が難しくなった **2012（0805）サイズ**のチップコンデンサを必要な範囲に限り変更。ユーザーの「0803」は既存回路図上の2012（0805）を指すものとして扱った。THT化案は撤回済みであり、再度取り入れない。既存の電解コンデンサ、抵抗、半導体、接続仕様は変更しない。

## 発注対象：変更したコンデンサ（1台9点／10台90点）

| 参照番号 | 数/台 | 元の部品 | 採用部品（秋月電子） | フットプリント変更 | 10台分の購入額 |
|---|---:|---|---|---|---:|
| C7/C8/C10/C14/C15/C16/C17 | 7 | 0.1 µF / 50 V、2012（0805） | 村田 **GRM188R72A104KA35D**、0.1 µF / 100 V、X7R、1608（0603）。販売コード **114559**。20個150円 | `Capacitor_SMD:C_0805_2012Metric` → `Capacitor_SMD:C_0603_1608Metric` | 4パック（80個）= **600円** |
| C2/C4 | 2 | 1 µF / 25 V、X5R、2012（0805） | 村田 **GRM188C81E105KA12**、1 µF / 25 V、X6S、1608（0603）。販売コード **116993**。40個120円 | 同上 | 1パック（40個）= **120円** |

**変更対象のみの10台分購入額：720円（計120個入手、90個使用、余り30個）。** 実使用数量で按分した10台分原価は585円、1台58.5円。送料・予備損耗・仕入変動は含まない。

出典：
- https://akizukidenshi.com/catalog/g/g114559/ （20個150円、100 V X7R、1608、通販在庫を2026-11-10確認）
- https://akizukidenshi.com/catalog/g/g116993/ （40個120円、25 V X6S、1608、通販在庫を2026-11-10確認）
- https://akizukidenshi.com/catalog/g/g117576/ （旧0.1 µF / 50 V X7R 2012、販売終了）
- https://akizukidenshi.com/catalog/g/g115331/ （旧1 µF / 50 V X7R 2012、入荷未定）

### 電気的差異の評価

- 0.1 µFの容量は維持、定格耐圧は50 V→100 Vで上位となる。X7Rを維持する。100 V品は印加3.3 Vに対して余裕があるが、容量のDCバイアス依存・実動作でのフィルタ/デカップリング特性は試作で測定する。
- **C2/C4の誘電体はX5R→X6Sに変更**。X6Sは−55～+105°C、容量変化±22%、X5Rは−55～+85°C、±15%。温度範囲は広がるが温度変化率は少し劣る。C2/C4は電源系デカップリング用途のため許容候補とし、実機で電源安定性とリップルを確認する。X5Rと完全同一とは表記しない。
- パッド寸法はKiCad 10標準の1608サイズ（中心±0.775 mm、0.9×0.95 mm）。元の2012サイズ（中心±0.95 mm、1.0×1.45 mm）から変更。実PCB位置とパッドUUID・接続ネットを維持した。

## 維持したコンデンサ

| 参照番号 | 数/台 | 仕様 | フットプリント | 調達参考情報 |
|---|---:|---|---|---|
| C1 | 1 | 10 µF / 35 V、X7R | 3216（1206） | 秋月 130977、`GMK316AB7106KL-TR`、20個200円。変更なし |
| C3/C6/C9/C13 | 4 | 100 µF / 16 V、電解THT | φ5 mm、P2.0 mm | 調達済み部品を維持。変更なし |
| C5/C12 | 2 | 1 nF / 50 V C0G（採用品は100 V C0G） | 2012（0805） | 千石 `GRM2165C2A102JA01D`（2026-11-10の2012カテゴリ掲載を確認、在庫実数は要発注時確認）。変更なし |
| C11/C19 | 2 | 1 µF / 25 V、B特性 | 1608（0603） | 秋月 130397、`GRM188B31E105KA75`、40個100円。変更なし |
| C18 | 1 | 10 µF / 6.3 V X5R（購入品は10 V X5R） | 2012（0805） | 秋月117592、`GRM21BR61A106KE19`、10個120円。変更なし |

保持品の出典：
- https://akizukidenshi.com/catalog/g/g130977/
- https://www.sengoku.co.jp/mod/sgk_cart/search.php?cid=4442
- https://akizukidenshi.com/catalog/g/g130397/
- https://akizukidenshi.com/catalog/g/g117592/

## KiCad修正内容と追跡

- `hardware/kicad/voicememory/voicememory.kicad_sch`：変更対象9個のValueおよびFootprintを更新。
- `hardware/kicad/voicememory/voicememory.kicad_pcb`：同じ9個のフットプリント形状・パッドサイズを標準1608へ変更。固定位置、端子番号、ネット名、UUIDは変更しない。
- KiCad内に既存の標準1608フットプリント（C11/C19）があり、それと同一のパッド・Silk/Fab/Courtyard寸法を使用。KiCad標準シンボルを簡略化して再生成していない。
- その他のフットプリント53個、セグメント455本、ビア154個、ゾーン定義は改変していない。
- 変更適用スクリプト：`scripts/apply_capacitor_sourcing_20261110.py`
- 静的監査スクリプト：`scripts/audit_capacitor_sourcing_20261110.py`
- 機械監査ログ：`hardware/reports/CAP_SOURCING_STATIC_AUDIT_2026-11-10.json`

## 監査と未完了事項

**済：** 参照番号と部品数、回路図・PCBのValue/Footprint整合、9個のパッド接続ネット/UUID/配置座標、他の部品や配線の差分チェック。変更前から銅配線がパッドに直接接触していた箇所は、変更後も接触が保持されることを簡易的な2D銅形状交差検査で確認。今回の変更による異なるネットの配線・ビアとの新規接触は検出されなかった。

**未：** **KiCad 10本体/CLIによるERC・DRC、ゾーン再フィル、シルク/パッドの全クリアランス、接続性の網羅検証、実機検証**。元データのGNDベタ塗りつぶしは未再フィル。静的検査は正式なKiCad DRCの代用にはならず、製造可能・DRC 0件とは判定しない。

変更前にも信号端子に銅配線の直接接触が見られない箇所（例：C15-1 PWM_F1、C17-1 PTT_SENSE_MCU、C4-1 +3V3）があり、**設計不良の断定ではなく未確認接続箇所として**KiCadの配線・ゾーン・パッド相互接続を検証する必要がある。C2/C4の小型化により電源デカップリングの実効容量が変化する可能性があるため、試作で電源電圧波形も確認する。

**適用後はPCBエディタの`B`キーで再フィルし、KiCad 10のERC・DRCを実行して記録すること。** タグ `v1` と `v1-eco-2026-10-30` は保持し、作業ブランチを別にする。
