T-labDevelopment/Voice_Memory/hardware/kicad/voicememory/README_CAP_SOURCING_2026-11-10.md

# v1部品調達改版（2026-11-10）

前回改版 `v1-eco-2026-10-30` に対して、入手性改善のため次のコンデンサのみ変更しました。

- **C7/C8/C10/C14/C15/C16/C17:** 0.1uF/50V、2012 → 0.1uF/100V、X7R、1608（秋月114559）
- **C2/C4:** 1uF/25V X5R、2012 → 1uF/25V X6S、1608（秋月116993）

他のコンデンサ、電解コンデンサ、抵抗、端子接続、RJ45固定穴修正、Flash、PhotoMOSは変更していません。

KiCad正式ERC/DRCとゾーン再フィルは未実施です。製造前に必ず実施してください。
詳細は `../../reports/CAP_SOURCING_2026-11-10_JA.md` を参照してください。
