T-labDevelopment/Voice_Memory/hardware/reports/CAP_MIN_0805_2026-11-10_10SETS.csv

参照番号 | 1台必要個数 | 10台必要個数 | 容量 | 耐圧 | 誘電体 | SMDサイズ | 部品分類 | メーカー型番 | 販売店 | 商品コード | 主購入単位 | 主購入単価円 | 主購入回数 | 追加購入回数 | 追加入数 | 追加単価円 | 購入総額円 | 在庫・判定 | URL
C7 C8 C10 C14 C15 C16 C17 | 7 | 70 | 0.1uF | 100V | CH (JIS) | 1206/3216 | SMD MLCC | Murata GRM31C2C2A104JA01L | 千石 | 型番検索 | 50 | 1200 | 1 | 2 | 10 | 300 | 1800 | 掲載あり、実在庫要確認 | https://www.sengoku.co.jp/mod/sgk_cart/search.php?cid=4440
C2 C4 C11 C19 | 4 | 40 | 1uF | 25V | PMLCAP film | 1206/3216 | SMD polymer film | Rubycon 25MU105MA23216 | 秋月 | 107397 | 1 | 70 | 40 | 0 | 0 | 0 | 2800 | 在庫あり、実装適合要確認 | https://akizukidenshi.com/catalog/g/g107397/
合計 | 11 | 110 |  |  |  |  |  |  |  |  |  |  |  |  |  |  | 4600 | 送料除く
