T-labDevelopment/Voice_Memory/releases/v2-manufacturing-approved-2026-11-11/README.md

# VoiceMemory v2 — 製造承認記録

**判定：製造承認済み**  
**承認日：2026-11-11**  
**承認者：プロジェクト責任者（本チャットのユーザー）**  
**承認方法：2026-11-11に「製造承認済みとして処理」と明示指示**

## 承認対象の固定

| 項目 | 値 |
|---|---|
| 対象版 | **VoiceMemory v2** |
| 基準ZIP | [`voicememory-2026-11-11_164201.zip`](../../hardware/source-archives/v2-baseline/voicememory-2026-11-11_164201.zip) |
| 基準ZIP SHA-256 | `a64d1d4d439a141a7048c7fe233227507cebeaa69209cd91ddddc90118438c7a` |
| ZIP登録場所 | `hardware/source-archives/v2-baseline/voicememory-2026-11-11_164201.zip` |
| 対応KiCad | [`hardware/kicad/voicememory/`](../../hardware/kicad/voicememory/) |
| 元ZIPからKiCadへの反映を確認したGitコミット | `e46e8d026885804b8783181245f9a54b088f07ca` |
| 原本ZIPサイズ | 217,137 bytes |
| 対象KiCadの構成 | 回路図、PCB、設定、シンボル、2フットプリント、2ライブラリテーブル |
| 元ZIPと展開ファイルの一致 | ZIPのハッシュ照合済み、Gitの対象8ファイルが一致 |
| v1との関係 | v1は別枠の旧試作・製造検証用版。**v1の費用計算は不要** |

この承認は**上記ハッシュの原本に対する設計上の製造リリース判断**である。原本以降の修正を承認済みとみなさない。最新版を確認する場合も、原本ハッシュを最優先する。

## 検証記録の確度

| 項目 | 判定 | 根拠 |
|---|---|---|
| 製造承認（管理上の判断） | **承認済み** | ユーザーからの明示指示 |
| ERCの実施 | **実施済み（ユーザー申告）** | ユーザーの発言 |
| DRCの実施 | **実施済み（ユーザー申告）** | ユーザーの発言 |
| ERCエラー0・警告0 | **結果未確認** | 正式ERCレポート未収録 |
| DRCエラー0・警告0 | **結果未確認** | 正式DRCレポート未収録 |
| ChatGPT側のKiCad CLI再検証 | **未実施** | 当該実行環境では未再実行 |
| 実装部品・PCB・無線機の実機動作 | **未確認** | 実測データ未受領 |
| Git上の原本およびKiCadファイル同定 | **確認済み** | 原本ハッシュ・Git Blob照合・インポート完了ログ |

**製造承認済みであることは、全テスト項目の独立検証が完了したという主張ではない。** 以降、検証資料が入手できれば別ファイルで追記し、既存の承認原本を改変しない。

## 再現・運用ルール

1. 製造用データは上記ZIPから採る。製造所提出時にハッシュを照合する。
2. GitHubの作業ブランチは後から更新される場合があるため、**基準ZIPのSHA-256を承認版識別の第一基準**とする。
3. 将来のPCB・回路修正は今回の承認を流用せず、新しい改訂版を作る。
4. 2026-11-10のC7/C10/C16/C19などの干渉監査は、今回承認されたPCBとは**別世代**のため、現行版の欠陥とは断定しない。
5. `main` への統合は別途承認がない限り行わない。

[以前の基準ZIP受領記録](../../hardware/reports/V2_BASELINE_RECEIPT_2026-11-11_JA.md)も参照。
