T-labDevelopment/Voice_Memory/hardware/kicad/voicememory/voicememory.kicad_pcb

## KiCad design hardware/kicad/voicememory/voicememory.kicad_pcb (2026-11-11)

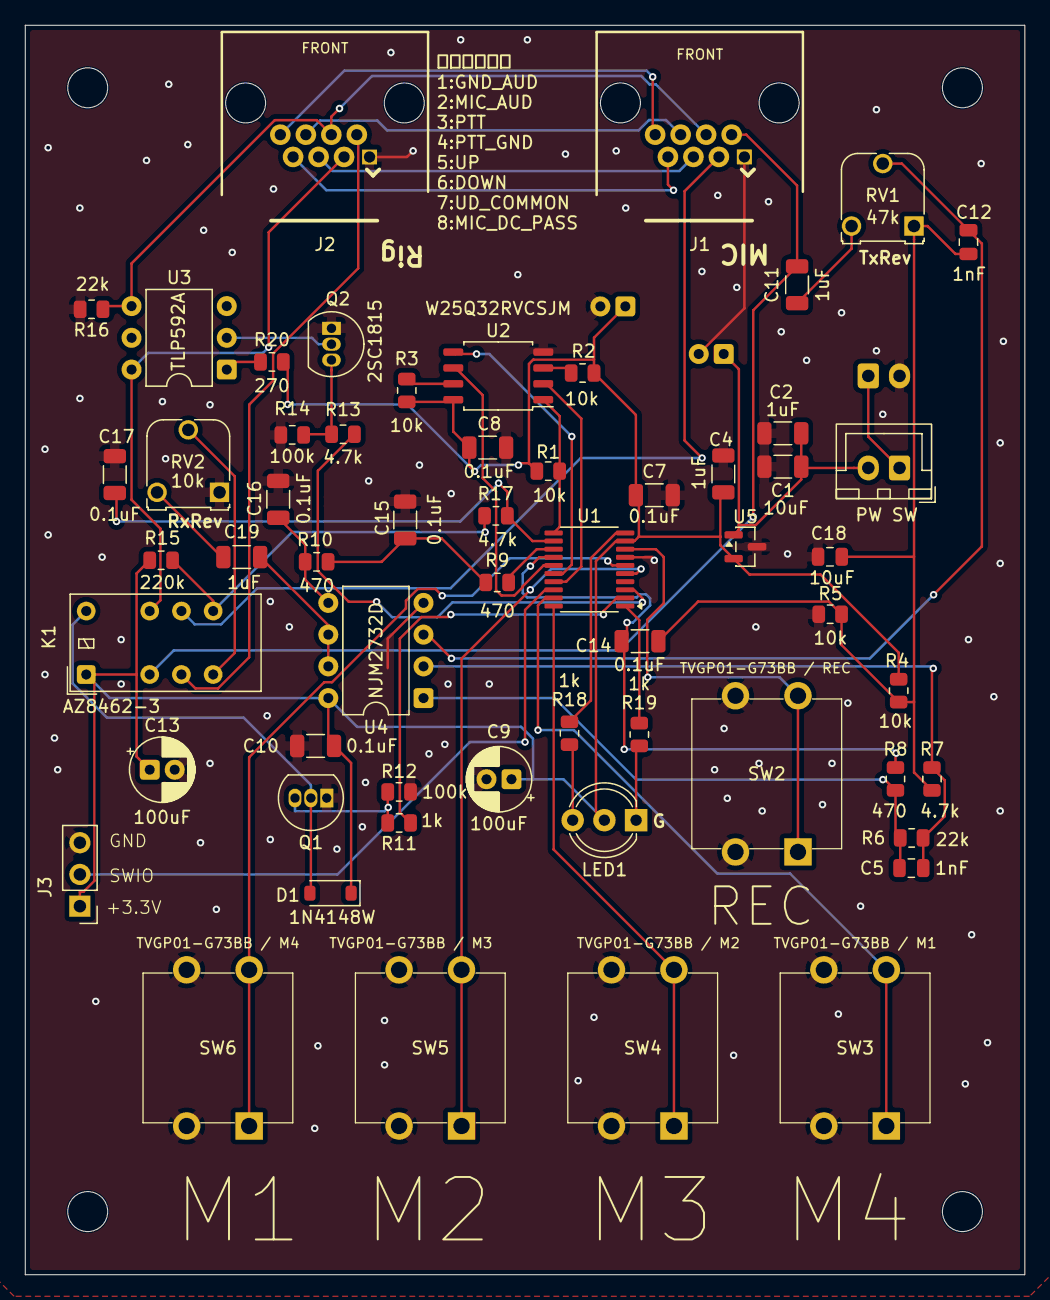
[picture p10: board voicememory.kicad_pcb from above]

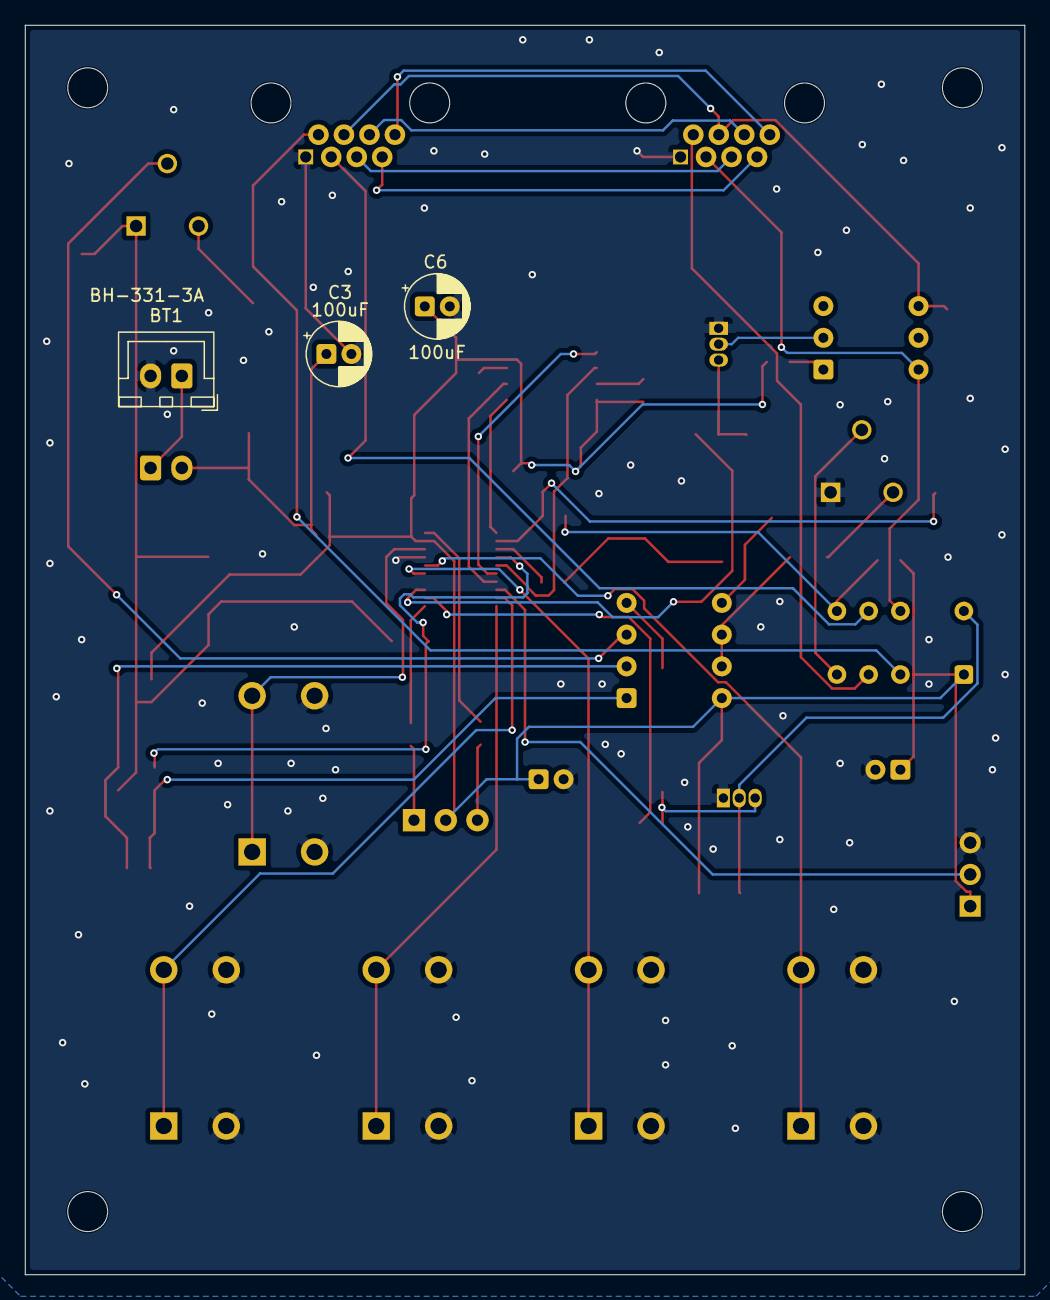
[picture p11: board voicememory.kicad_pcb from below]

Board: 2 copper layers, 80.0 x 100.0 mm, 61 parts (3 on the bottom side), 50 nets.

Parts:
BT1: BH-331-3A; JST_XH_B2B-XH-A_1x02_P2.50mm_Vertical
C1: 10uF; C_1206_3216Metric
C2, C4, C11, C19: 1uF; C_1206_3216Metric
C3, C6, C9, C13: 100uF; CP_Radial_D5.0mm_P2.00mm
C5, C12: 1nF; C_0805_2012Metric
C7, C8, C10, C14, C15, C16, C17: 0.1uF; C_1206_3216Metric
C18: 10uF; C_0805_2012Metric
D1: 1N4148W; D_SOD-123
J1: RJ45_8P8C MIC; RJ45_8P8C_THT_15.91x15.10
J2: RJ45_8P8C RIG; RJ45_8P8C_THT_15.91x15.10
J3: WCH-Link 3P; PinHeader_1x03_P2.54mm_Vertical
K1: AZ8462-3; Relay_DPDT_Kemet_EC2_NU
LED1: LT6CU7R; LED_D5.0mm-3
Q1: 2SC1815L-Y-T92; TO-92_Inline
Q2: 2SC1815; TO-92_Inline
R1, R2, R3, R4, R5: 10k; R_0805_2012Metric
R6, R16: 22k; R_0805_2012Metric
R7, R13, R17: 4.7k; R_0805_2012Metric
R8, R9, R10: 470; R_0805_2012Metric
R11, R18, R19: 1k; R_0805_2012Metric
R12, R14: 100k; R_0805_2012Metric
R15: 220k; R_0805_2012Metric
R20: 270; R_0805_2012Metric
RV1: 47k; Potentiometer_Runtron_RM-065_Vertical
RV2: 10k; Potentiometer_Runtron_RM-065_Vertical
SW1: CW-SB11KKFF; JST_XH_B2B-XH-A_1x02_P2.50mm_Vertical
SW2: TVGP01-G73BB / REC; SW_TVGP01_G73BB_12mm
SW3: TVGP01-G73BB / M1; SW_TVGP01_G73BB_12mm
SW4: TVGP01-G73BB / M2; SW_TVGP01_G73BB_12mm
SW5: TVGP01-G73BB / M3; SW_TVGP01_G73BB_12mm
SW6: TVGP01-G73BB / M4; SW_TVGP01_G73BB_12mm
U1: CH32V003F4P6; TSSOP-20_4.4x6.5mm_P0.65mm
U2: W25Q32RVCSJM; SOP-8_5.28x5.23mm_P1.27mm
U3: TLP592A; DIP-6_W7.62mm
U4: NJM2732D; DIP-8_W7.62mm
U5: AP7333-33SAG; SOT-23

Connections:
+3V3: C4.1, C6.1, C7.1, C8.1, C9.1, C10.1, C13.1, D1.1 (K), J3.1, K1.1 (COIL+), LED1.2 (A_COMMON), R1.2, R2.2, R3.2, R4.1, R15.1, R20.1, U1.9 (VDD), U2.8 (VCC), U4.8 (V+), U5.2 (OUT)
AQV_LED_A: R20.2, U3.1 (A)
AQV_LED_K: Q2.2 (C), U3.2 (K)
AUDIO_ADC: C14.1, R8.2, U1.14 (PC4)
AUDIO_PWM: R9.1, U1.13 (PC3)
AUTO_PTT_EN: R13.1, U1.3 (PD6)
FLASH_CS: R1.1, U1.11 (PC1), U2.1 (/CS)
FLASH_HOLD_N: R3.1, U2.7 (/HOLD/IO3)
FLASH_WP_N: R2.1, U2.3 (/WP/IO2)
GND_AUD: BT1.2 (-), C1.2, C2.2, C3.2, C4.2, C6.2, C7.2, C8.2, C9.2, C10.2, C13.2, C15.2, C16.2, C17.2, C18.2, J1.1, J2.1, J3.3, Q1.1 (E), Q2.1 (E), R5.2, R12.2, R14.2, R16.2, RV2.1, SW2.2, SW3.2, SW4.2, SW5.2, SW6.2, U1.7 (VSS), U2.4 (GND), U4.4 (V-), U5.3 (GND)
LED_G: R19.2, U1.1 (PD4)
LED_G_K: LED1.1 (K_YG), R19.1
LED_R: R18.2, U1.10 (PC0)
LED_R_K: LED1.3 (K_RED), R18.1
MIC_AUDIO: C11.1, J1.2, K1.3 (A_NC)
MIC_DC_PASS: J1.8, J2.8
MIC_DOWN: J1.6, J2.6
MIC_PTT: J1.3, K1.9 (B_COM)
MIC_UP: J1.5, J2.5
PLAY_AC: C19.2, RV2.3
PLAY_BIASED: C19.1, U4.6 (-), U4.7
PLAY_OUT: K1.5 (A_NO), RV2.2
PTT_GND: J1.4, J2.4, R16.1, U3.4 (DRAIN_D1)
PTT_SENSE_LOCAL: K1.8 (B_NO), R15.2, R17.1
PTT_SENSE_MCU: C17.1, R17.2, U1.12 (PC2)
PWM_F1: C15.1, R9.2, R10.1
PWM_F2: C16.1, R10.2, U4.5 (+)
Q1_BASE: Q1.3 (B), R11.2, R12.1
Q2_BASE: Q2.3 (B), R13.2, R14.1
REC_AC: C11.2, RV1.3
REC_AMP_OUT: C5.1, R6.1, R8.1, U4.1
REC_FB: C5.2, R6.2, R7.1, U4.2 (-)
REC_LEVEL: C12.1, RV1.2, U4.3 (+)
RELAY_COIL_LOW: D1.2 (A), K1.12 (COIL-), Q1.2 (C)
RELAY_EN: R11.1, U1.2 (PD5)
RIG_AUDIO: J2.2, K1.4 (A_COM)
RIG_PTT: J2.3, K1.10 (B_NC), U3.6 (DRAIN_D2)
SPI_MISO: U1.17 (PC7), U2.2 (DO/IO1)
SPI_MOSI: U1.16 (PC6), U2.5 (DI/IO0)
SPI_SCK: U1.15 (PC5), U2.6 (CLK)
SWIO: J3.2, U1.18 (PD1/SWIO)
SW_M1_N: SW3.1, U1.19 (PD2)
SW_M2_N: SW4.1, U1.20 (PD3)
SW_M3_N: SW5.1, U1.5 (PA1)
SW_M4_N: SW6.1, U1.6 (PA2)
SW_REC_N: SW2.1, U1.8 (PD0)
UD_COMMON: J1.7, J2.7
VBAT_RAW: BT1.1 (+), SW1.1 (A)
VBAT_SW: C1.1, C2.1, C3.1, SW1.2 (B), U5.1 (IN)
VREF: C12.2, C14.2, C18.1, R4.2, R5.1, R7.2, RV1.1
