T-labDevelopment/Voice_Memory/(commit log)

2026-11-10 import: VoiceMemory v1 KiCad 10 latest review snapshot (source c046a9c)
    Import v1 hardware, PCB, footprints, firmware developer documentation, BOM, scripts and audit reports.
    Retain the original local Git history as a verified four-part Git bundle under history/.
    This snapshot is not KiCad ERC/DRC approved. main is left at repository initialization.
    [CAP_MIN_0805_2026-11-10_10SETS.csv, pinmap_CH32V003F4P6_legacySCH.csv, voicememory.kicad_pcb, voicememory.kicad_sch]
2026-11-10 docs: add current KiCad component delta for firmware developers
2026-11-10 docs: verify uploaded 2026-10-30 ECO ZIP against current KiCad branch
2026-11-10 docs: classify V1 as prototype verification baseline and set active development to V2
2026-11-10 docs: clarify V2 current file locations and exclude V1 prototype costing
2026-11-11 baseline(v2): archive 2026-11-11 verified-user KiCad package and record ERC/DRC provenance
2026-11-11 hardware(v2): apply 2026-11-11 verified baseline KiCad ZIP
    [voicememory.kicad_pcb]
2026-11-11 release(v2): record owner manufacturing approval for 2026-11-11 KiCad baseline
